JasonFriedman/FanSpeed/(commit log)

2025-08-28 Initial commit
    Description and code for building a device to measure fan speed
2025-08-28 Fix link to Hall effect sensor
